hicked/Motorcycle-Brakes-and-Signals/media/Screenshot 2025-01-05 164944.png

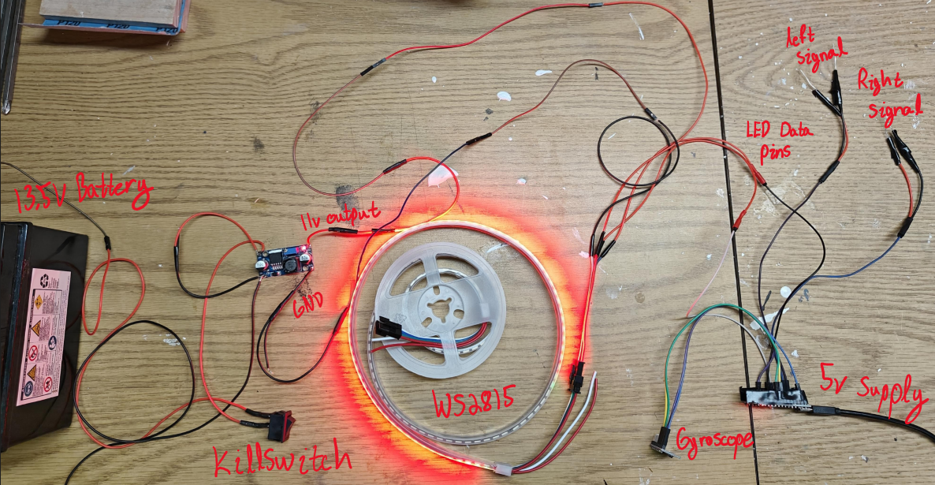
media/Screenshot 2025-01-05 164944.png
