hicked/Motorcycle-Brakes-and-Signals/media/Notes.md

- 12V LED strips WS2815 
- Arduino Nano (controls the system logic)
- MOSFET (IRLZ44N) controlled by nano (to switch the ground side of the LED strips)
- 12V motorcycle battery (power source)
- DC-DC Buck LM2596 Voltage regulator (either onboard or external for stepping down 12V to 5V for the Arduino)
- Manual switch from battery -> voltage regulator -> nano to turn it off manually if needed

https://www.aliexpress.com/item/32401358878.html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
https://www.aliexpress.com/item/1005005278857364.html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
https://www.aliexpress.com/item/1005007066680464.html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
https://www.aliexpress.com/item/32714396199.html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
https://www.aliexpress.com/item/1005004904872120.html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
