hicked/Motorcycle-Brakes-and-Signals/media/Screenshot 2025-01-05 165439.png

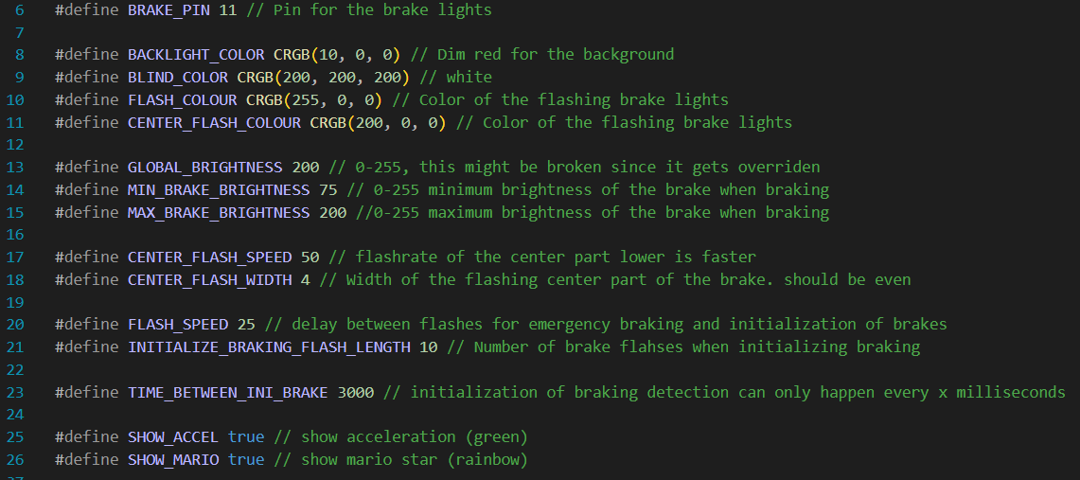
media/Screenshot 2025-01-05 165439.png
