hicked/Motorcycle-Brakes-and-Signals/media/Screenshot 2025-01-22 014738.png

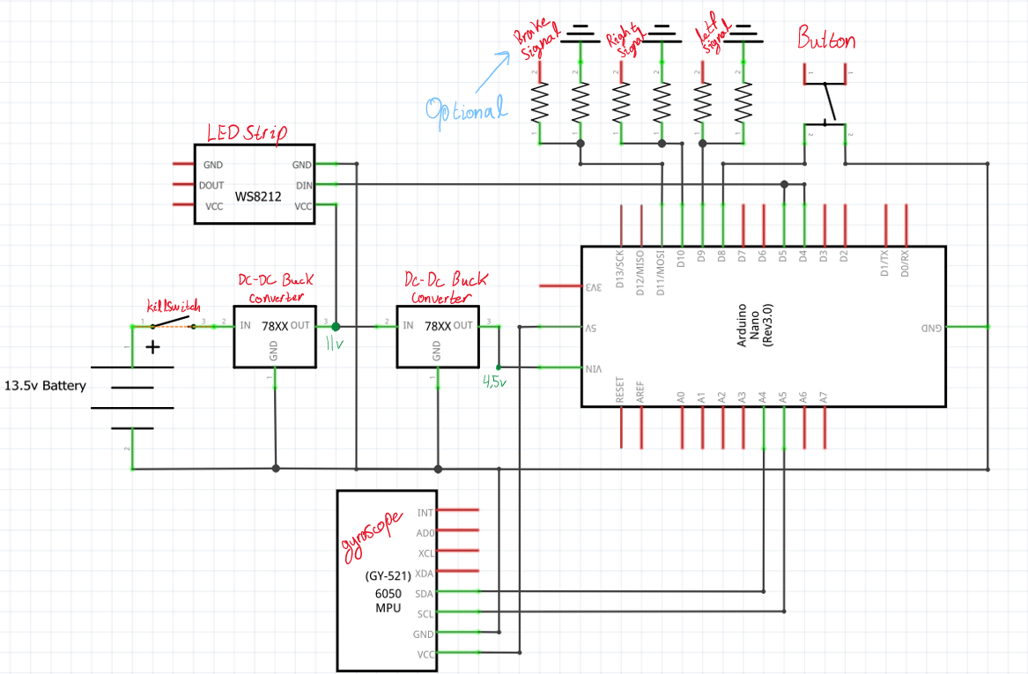
media/Screenshot 2025-01-22 014738.png
