hicked/Motorcycle-Brakes-and-Signals/main/gyro.h

#pragma once
#include <Wire.h>
#include "button.h"

// green light on gyro towards back
#define MPU6050_ADDR 0x68  // MPU6050 I2C address

// divide all these values by 17000 to get the amount in g force
#define MIN_GYRO_BREAKING 35 // Buffer area where gyro wont do anything
#define MAX_GYRO_BREAKING 550 // Max value of gyro when braking. anything more will be emergency braking

#define MIN_GYRO_ACCELERATING 800 // buffer area where gyro wont do anything
#define MAX_GYRO_ACCELERATING 8000 // maximum value of gyro when accelerating

#define FORCE_EXPECTED_MAGNITUDE true  // Whether to override bad calibration values
#define EXPECTED_ACC_MAGNITUDE 4115 // expected value of acceleration when stationary (gravity only). Defaults to this if calibration fails
#define CALIBRATION_SAMPLE_SIZE 250 // sample size for calibration phase
#define CALIBRATION_ACC_DELTA 2000 // ensures that the acc found during calibration is within this of EXPECTED_ACC_MAGNITUDE

// WARNING!!! MEDIAN_SAMPLE_SIZE IS VERY MEMORY INTENSIVE. STICK TO max 150 OR MEMORY WILL FRAGMENT
#define MEDIAN_SAMPLE_SIZE 20 // higher value is more accurate, but slower. Used to detect hills

// Finaly, it smoothes the previous and new values together instead of just setting them
#define X_SMOOTHING 0.20
#define Y_SMOOTHING 1
#define Z_SMOOTHING 0.08 // smoothing for irregularities like bumps
#define GLOBAL_SMOOTHING 0.225 // lower value is more smoothing, less vibrations, but less reactive/fast. 1 means no smoothing

class Gyro {
    private:
        // Hardware references
        Button* button;
        
        // Calibration data
        int idleAcc = 0;

        // Sensor readings
        int measuredAccX = 0;
        int measuredAccY = 0;
        int measuredAccZ = 0;

        int smoothedAccX = 0;
        int smoothedAccY = 0;
        int smoothedAccZ = 0;

        int prevSmoothedAccX = 0;
        int prevSmoothedAccY = 0;
        int prevSmoothedAccZ = 0;

        int sampleAccelerationMagnitudes[MEDIAN_SAMPLE_SIZE];
        int numMedianSample = 0;

        // Filtered outputs
        int correctedYAcceleration = 0;

        // Timing
        unsigned long lastUpdateTime = 0;

        bool readRawAccel();
        void initializeMPU();
        int median(int samples[], int size);

    public:
        int smoothedAndCorrectedYAcc = 0;
        int prevSmoothedAndCorrectedYAcc = 0;

        Gyro(Button* button);
        void update();
        float getAcceleration();
        float getRawAcceleration();
        void debugI2CPins();
};
