hicked/Motorcycle-Brakes-and-Signals/main/signals.h

#pragma once
#include <FastLED.h> // 3.9.9
#include <Arduino.h>
#include "brake.h"
#include "button.h"

#define LEFT_SIGNAL_PIN 9
#define RIGHT_SIGNAL_PIN 10

#define SIGNAL_COLOUR CRGB(255, 65, 0) // orange

#define SIGNAL_OFF_DELAY 1000 // if the signal pin is off for this long, turn off the signal
#define SIGNAL_SPEED 20 // 60 to 120 flashes per minute check this legal requirement
#define SIGNAL_LENGTH 25 // length of the signal in LEDs
#define PAUSE_TIME 250

class Signals {
private:
    CRGB *LEDStrip; // Pointer to the LED strip
    Button *button;
    unsigned long lastSignalUpdate = 0; // time of the last flash

    unsigned long leftLastHighTime = 0;
    unsigned long rightLastHighTime = 0;

    int numLEDs;
    int numActiveLEDs = 0;

public:
    bool left = false;
    bool right = false;

    Signals(CRGB *leds, Button *button, int num_leds);
    void update();
    void updateStates();
    void leftSignal();
    void rightSignal();
};
