hicked/Motorcycle-Brakes-and-Signals/(commit log)

2025-01-22 fixed gyro header
2025-01-30 Gyro detection rework
2025-01-30 improving gyro sensor detection
2025-01-31 gyro patch
2025-02-01 delta filtering for hill detection
2025-02-14 v.2.1.3 Added Y offset by compairing avg magnitude. Adjusted hill sample size. Yet to be tested.
2025-02-16 new gyro strategy
2025-04-29 fixed smoothing parameters for gyro
    [gyro.cpp, gyro.h]
2025-05-01 refactoring and printing
2025-05-02 magnitude gyro rework
2025-05-16 v0.7.0-beta gyro rework
2025-05-16 v0.7.0-beta part 2 gyro rework
    [gyro.cpp, gyro.h]
